tyronemc2/pi_irrigation/(commit log)

2026-10-02 Greenhouse irrigation: ESP32 firmware, Pi dashboard (PWA), scheduler, tests
    - ESP32 firmware (Wemos Lolin32 OLED) using the build-manual pin plan:
    valves A/B with on-board safety timers, soil x3, DS18B20, floats, flow,
    HTTP API, OTA, optional refill (top-up) and pump interlock on C/D
    - Pi app: hydro cycles + bed daily schedules, moisture skip, tank-low
    lockout, one zone at a time, no-flow stop, leak and offline alerts,
    ntfy notifications, rain forecast (off for covered greenhouse)
    - Installable PWA dashboard for Android and iPhone
    - Installer + systemd service, optional Tailscale HTTPS
    - 65 tests incl. 2-day soak; GitHub Actions CI for tests and firmware
    [config.example.h, config.example.yaml, irrigation_esp32.ino]
2026-10-05 Refill top-up after 2 min below HIGH so bed runs don't drain the tank to LOW
2026-10-05 Air temperature: hourly 4-day history chart and table, temperature-triggered watering rules
2026-10-05 Three beds on valve B: Wall Bed, Window Bed, Alley Pots; water unless every bed is moist
2026-10-17 Run zones together, 3 valves (A Window Bed, B Wall Bed, C Pots), firmware for 26-pin board
